garin29/Guitar-Amp-Sim/Audio processor V4 PCB Folder/3D View/Side View.PNG

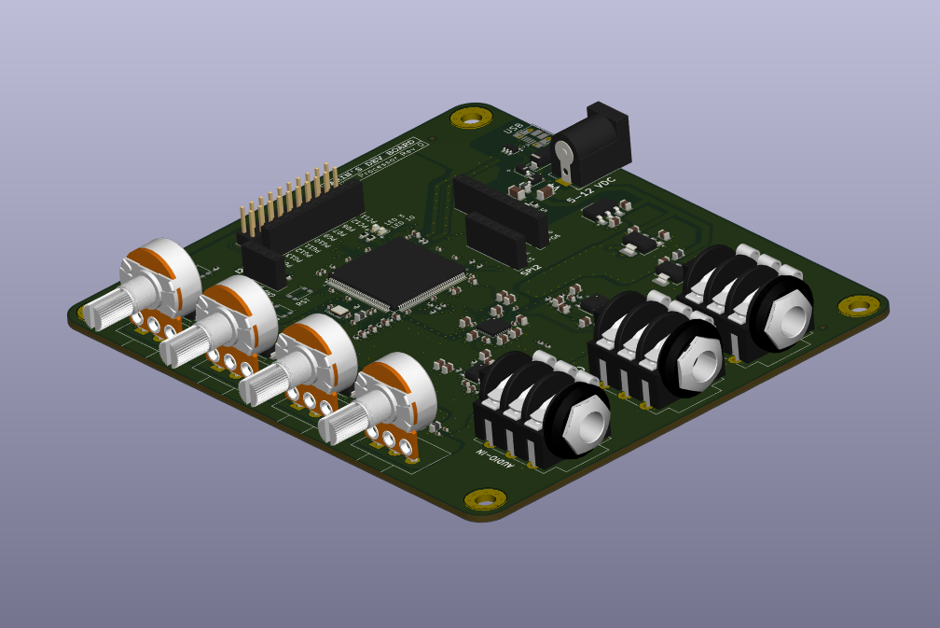
Audio processor V4 PCB Folder/3D View/Side View.PNG
