garin29/Guitar-Amp-Sim/Audio processor V4 PCB Folder/Schematic Audio Processor V.0.2.png

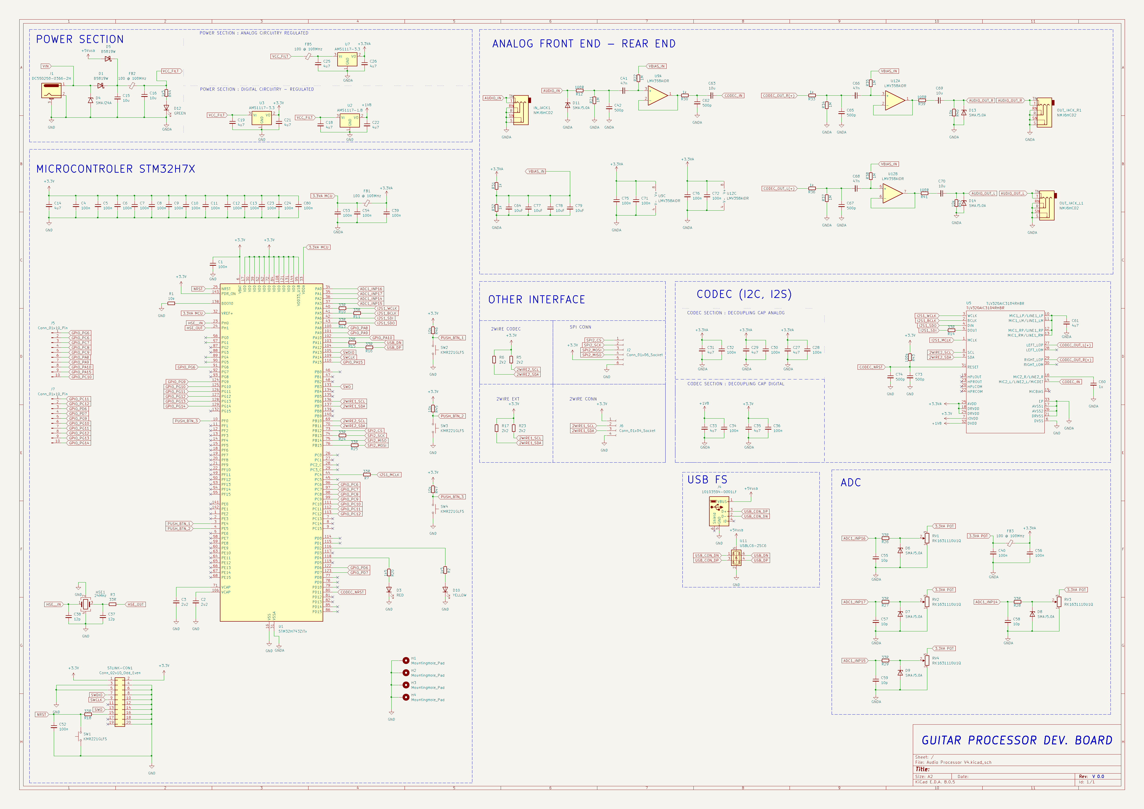
Audio processor V4 PCB Folder/Schematic Audio Processor V.0.2.png
