garin29/Guitar-Amp-Sim/Audio processor V4 PCB Folder/Assembly/Audio Processor V4 BOM - obs.csv

Comment | Designator | Footprint | LCSC
Conn_01x10_Pin | J7 | Connector_PinSocket_2.54mm:PinSocket_1x10_P2.54mm_Vertical | C22438160
Conn_01x10_Pin | J5 | Connector_PinSocket_2.54mm:PinSocket_1x10_P2.54mm_Vertical | C22438160
DC550250-0366-2H | J1 | Connector_BarrelJack:BarrelJack_Horizontal | C7428747
Conn_01x04_Socket | J6 | Connector_PinSocket_2.54mm:PinSocket_1x04_P2.54mm_Vertical | C2718488
USBLC6-2SC6 | U11 | Package_TO_SOT_SMD:TSOT-23-6 | C2687116
10103594-0001LF | J4 | Connector_USB:USB_Micro-B_Amphenol_10103594-0001LF_Horizontal | C428495
RK1631110U1Q | RV4 | Potentiometer_THT:Potentiometer_Alps_RK163_Single_Horizontal | C370978
RK1631110U1Q | RV3 | Potentiometer_THT:Potentiometer_Alps_RK163_Single_Horizontal | C370978
RK1631110U1Q | RV2 | Potentiometer_THT:Potentiometer_Alps_RK163_Single_Horizontal | C370978
RK1631110U1Q | RV1 | Potentiometer_THT:Potentiometer_Alps_RK163_Single_Horizontal | C370978
NMJ6HCD2 | OUT_JACK_R1 | Connector_Audio:Jack_6.35mm_Neutrik_NMJ6HCD2_Horizontal | C368502
NMJ6HCD2 | OUT_JACK_L1 | Connector_Audio:Jack_6.35mm_Neutrik_NMJ6HCD2_Horizontal | C368502
NMJ6HCD2 | IN_JACK1 | Connector_Audio:Jack_6.35mm_Neutrik_NMJ6HCD2_Horizontal | C368502
LMV358AIDR | U12 | Package_SO:PowerIntegrations_SO-8 | C182039
LMV358AIDR | U9 | Package_SO:PowerIntegrations_SO-8 | C182039
TLV320AIC3104RHBR | U5 | Package_DFN_QFN:VQFN-32-1EP_5x5mm_P0.5mm_EP3.5x3.5mm_ThermalVias | C181753
SMAJ24A | D4 | Diode_SMD:D_SMA | C148222
STM32H743ZITx | U1 | Package_QFP:LQFP-144_20x20mm_P0.5mm | C114408
SMAJ5.0A | D14 | Diode_SMD:D_SMA | C113952
SMAJ5.0A | D13 | Diode_SMD:D_SMA | C113952
SMAJ5.0A | D11 | Diode_SMD:D_SMA | C113952
SMAJ5.0A | D9 | Diode_SMD:D_SMA | C113952
SMAJ5.0A | D8 | Diode_SMD:D_SMA | C113952
SMAJ5.0A | D7 | Diode_SMD:D_SMA | C113952
SMAJ5.0A | D6 | Diode_SMD:D_SMA | C113952
KMR221GLFS | SW4 | Button_Switch_SMD:SW_Push_1P1T_NO_CK_KMR2 | C72443
KMR221GLFS | SW3 | Button_Switch_SMD:SW_Push_1P1T_NO_CK_KMR2 | C72443
KMR221GLFS | SW2 | Button_Switch_SMD:SW_Push_1P1T_NO_CK_KMR2 | C72443
KMR221GLFS | SW1 | Button_Switch_SMD:SW_Push_1P1T_NO_CK_KMR2 | C72443
B5819W | D5 | Diode_SMD:D_SOD-123 | C64885
B5819W | D1 | Diode_SMD:D_SOD-123 | C64885
Conn_01x06_Socket | J2 | Connector_PinSocket_2.54mm:PinSocket_1x06_P2.54mm_Vertical | C40877
1M | R38 | Resistor_SMD:R_0402_1005Metric | C26083
1M | R37 | Resistor_SMD:R_0402_1005Metric | C26083
1M | R35 | Resistor_SMD:R_0402_1005Metric | C26083
1M | R34 | Resistor_SMD:R_0402_1005Metric | C26083
1M | R22 | Resistor_SMD:R_0402_1005Metric | C26083
1M | R21 | Resistor_SMD:R_0402_1005Metric | C26083
10k | R47 | Resistor_SMD:R_0402_1005Metric | C25744
10k | R46 | Resistor_SMD:R_0402_1005Metric | C25744
10k | R45 | Resistor_SMD:R_0402_1005Metric | C25744
10k | R42 | Resistor_SMD:R_0402_1005Metric | C25744
10k | R40 | Resistor_SMD:R_0402_1005Metric | C25744
10k | R1 | Resistor_SMD:R_0402_1005Metric | C25744
100k | R43 | Capacitor_SMD:C_0402_1005Metric | C25530
33R | R29 | Resistor_SMD:R_0402_1005Metric | C25105
33R | R28 | Resistor_SMD:R_0402_1005Metric | C25105
33R | R27 | Resistor_SMD:R_0402_1005Metric | C25105
33R | R26 | Resistor_SMD:R_0402_1005Metric | C25105
33R | R25 | Resistor_SMD:R_0402_1005Metric | C25105
33R | R24 | Resistor_SMD:R_0402_1005Metric | C25105
33R | R18 | Resistor_SMD:R_0402_1005Metric | C25105
33R | R16 | Resistor_SMD:R_0402_1005Metric | C25105
33R | R15 | Resistor_SMD:R_0402_1005Metric | C25105
33R | R14 | Resistor_SMD:R_0402_1005Metric | C25105
33R | R13 | Resistor_SMD:R_0402_1005Metric | C25105
33R | R11 | Resistor_SMD:R_0402_1005Metric | C25105
33R | R10 | Resistor_SMD:R_0402_1005Metric | C25105
33R | R7 | Resistor_SMD:R_0402_1005Metric | C25105
33R | R3 | Resistor_SMD:R_0402_1005Metric | C25105
100R | R41 | Resistor_SMD:R_0402_1005Metric | C25076
100R | R39 | Resistor_SMD:R_0402_1005Metric | C25076
100R | R12 | Resistor_SMD:R_0402_1005Metric | C25076
1k5 | R44 | Resistor_SMD:R_0603_1608Metric | C22843
1k5 | R20 | Resistor_SMD:R_0603_1608Metric | C22843
1k5 | R2 | Resistor_SMD:R_0603_1608Metric | C22843
24MHz | HSE1 | Crystal:Crystal_SMD_3225-4Pin_3.2x2.5mm | C15643
1k | R36 | Resistor_SMD:R_0402_1005Metric | C11702
1k | R33 | Resistor_SMD:R_0402_1005Metric | C11702
1k | R32 | Resistor_SMD:R_0402_1005Metric | C11702
1k | R31 | Resistor_SMD:R_0402_1005Metric | C11702
1k | R30 | Resistor_SMD:R_0402_1005Metric | C11702
AMS1117-3.3 | U7 | Package_TO_SOT_SMD:SOT-223-3_TabPin2 | C6186
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
100n | C1 | Capacitor_SMD:C_0402_1005Metric | C1525
100 @ 100MHz | FB5 | Inductor_SMD:L_0805_2012Metric | C1015
100 @ 100MHz | FB3 | Inductor_SMD:L_0805_2012Metric | C1015
100 @ 100MHz | FB2 | Inductor_SMD:L_0805_2012Metric | C1015
100 @ 100MHz | FB1 | Inductor_SMD:L_0805_2012Metric | C1015
