garin29/Guitar-Amp-Sim/Audio processor V4 PCB Folder/Audio Processor V4.kicad_pcb

## KiCad design Audio processor V4 PCB Folder/Audio Processor V4.kicad_pcb (2025-03-13)

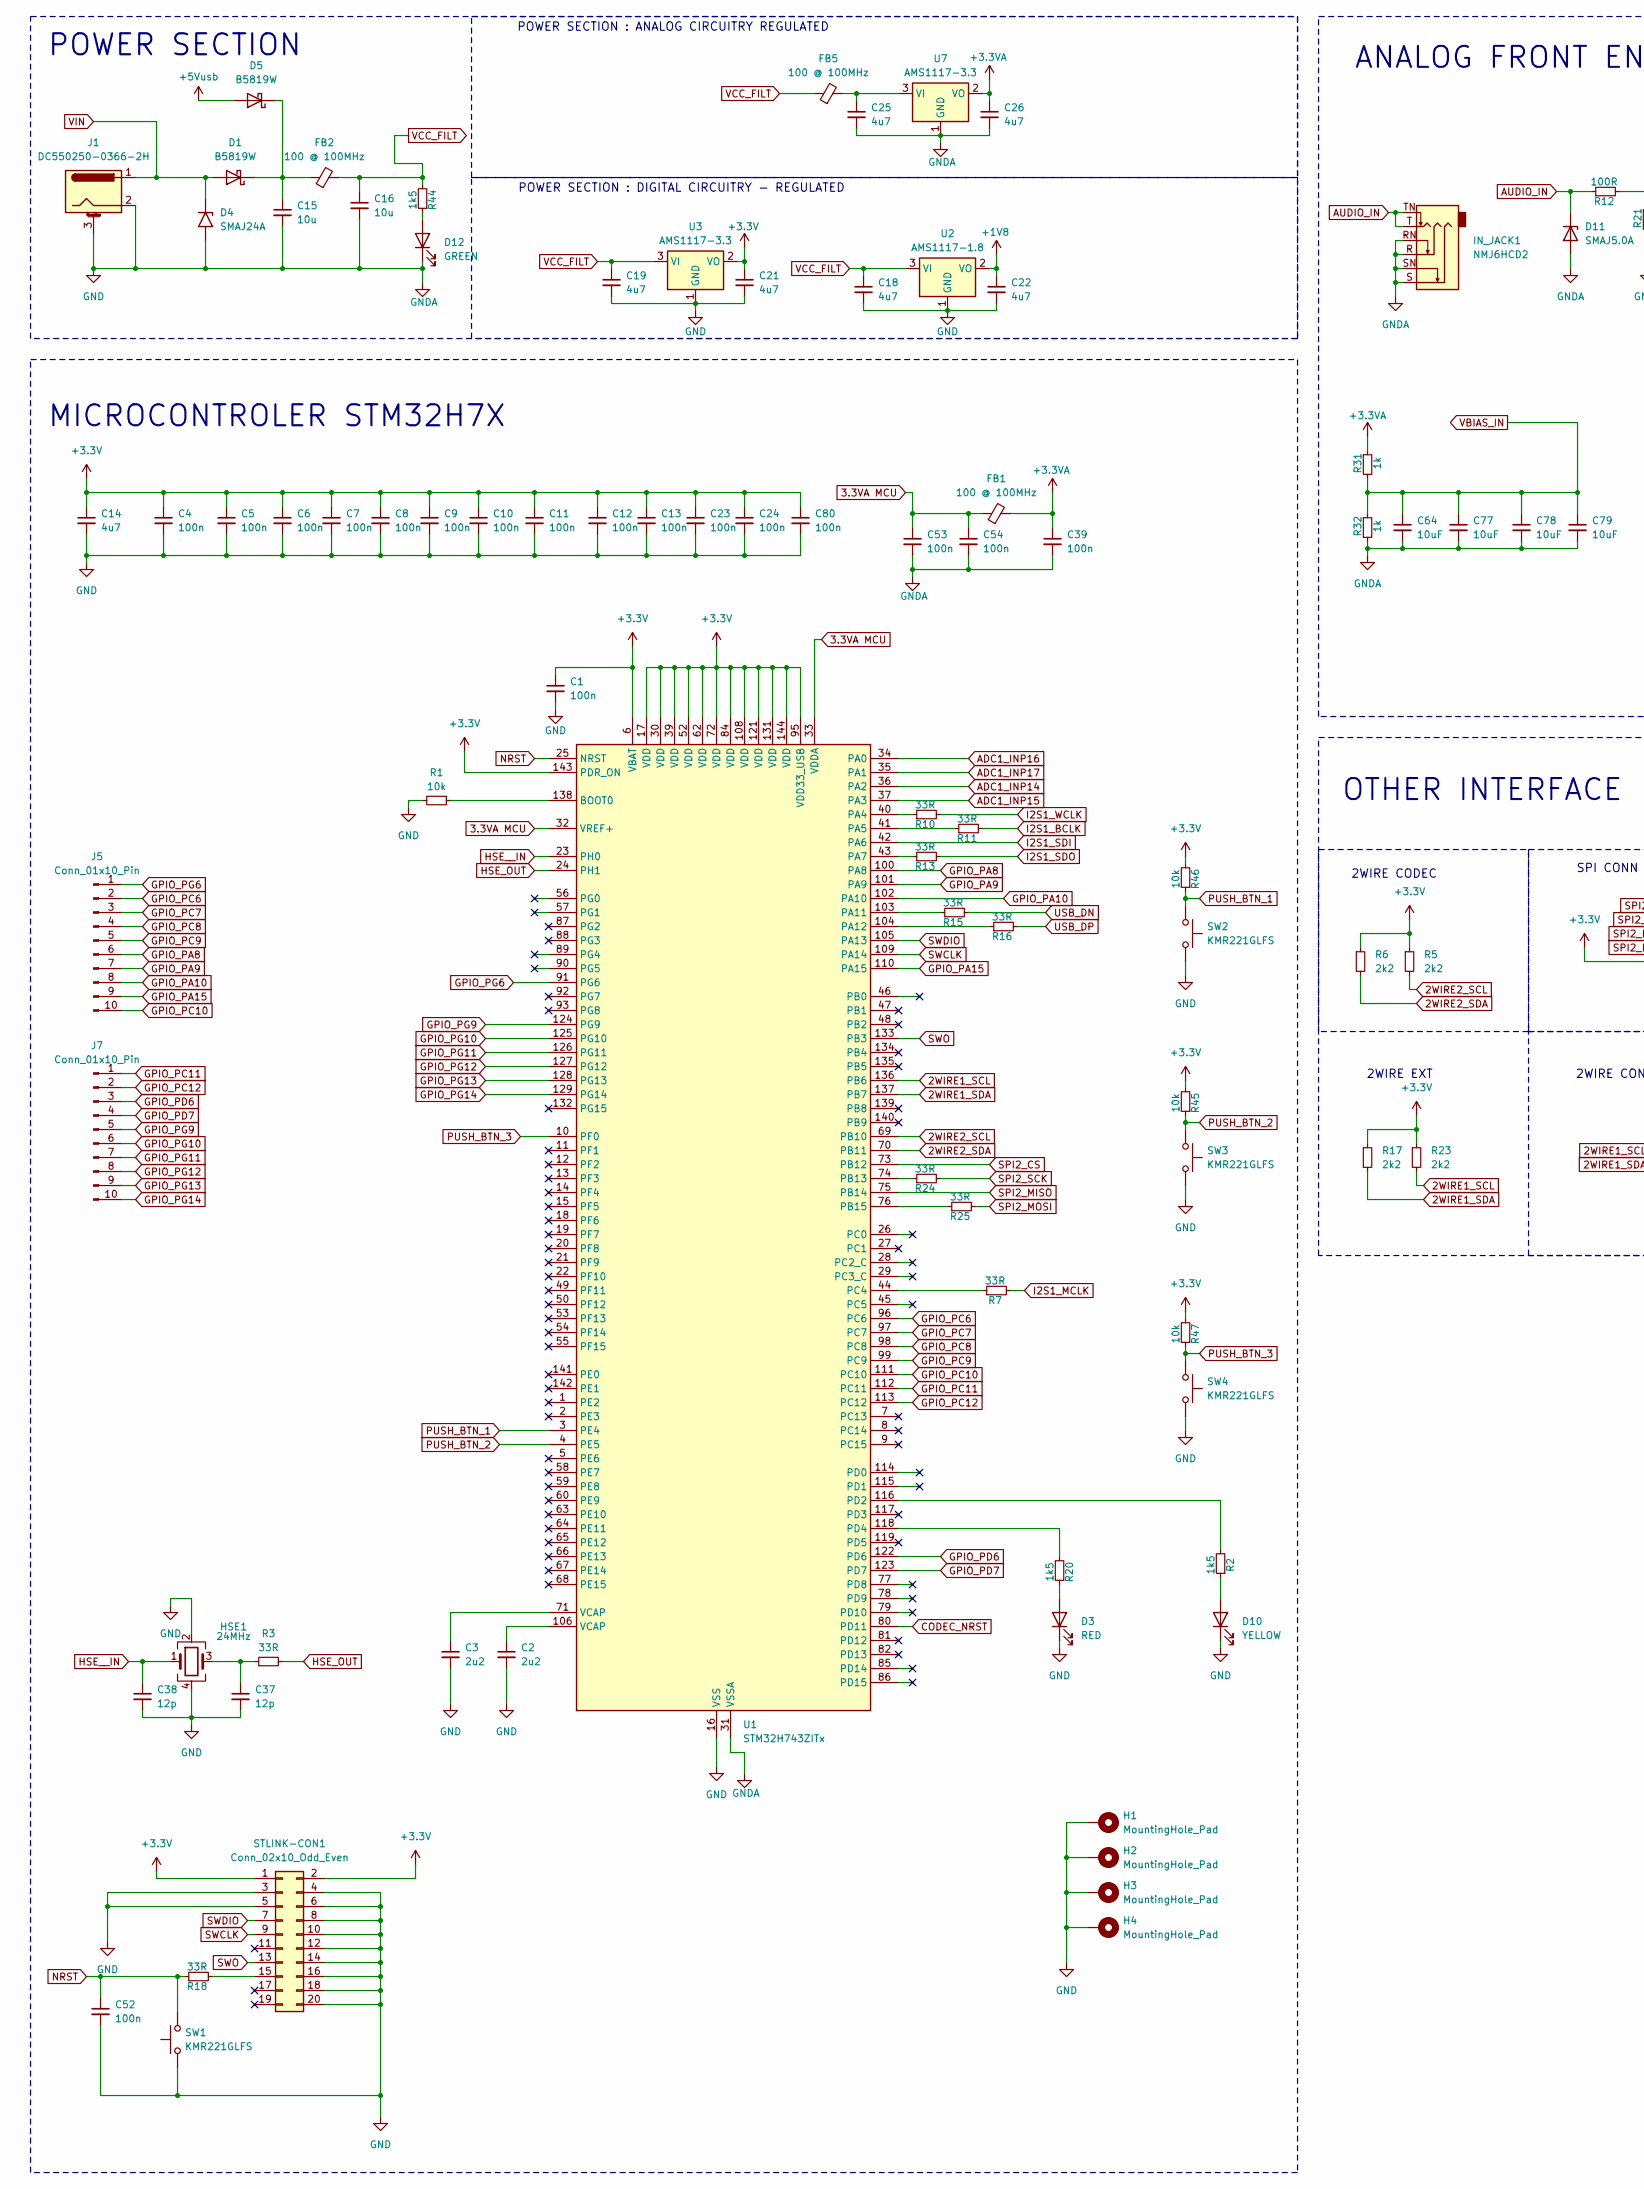
[picture p21: schematic Audio Processor V4.kicad_sch, part in row 1, column 1]

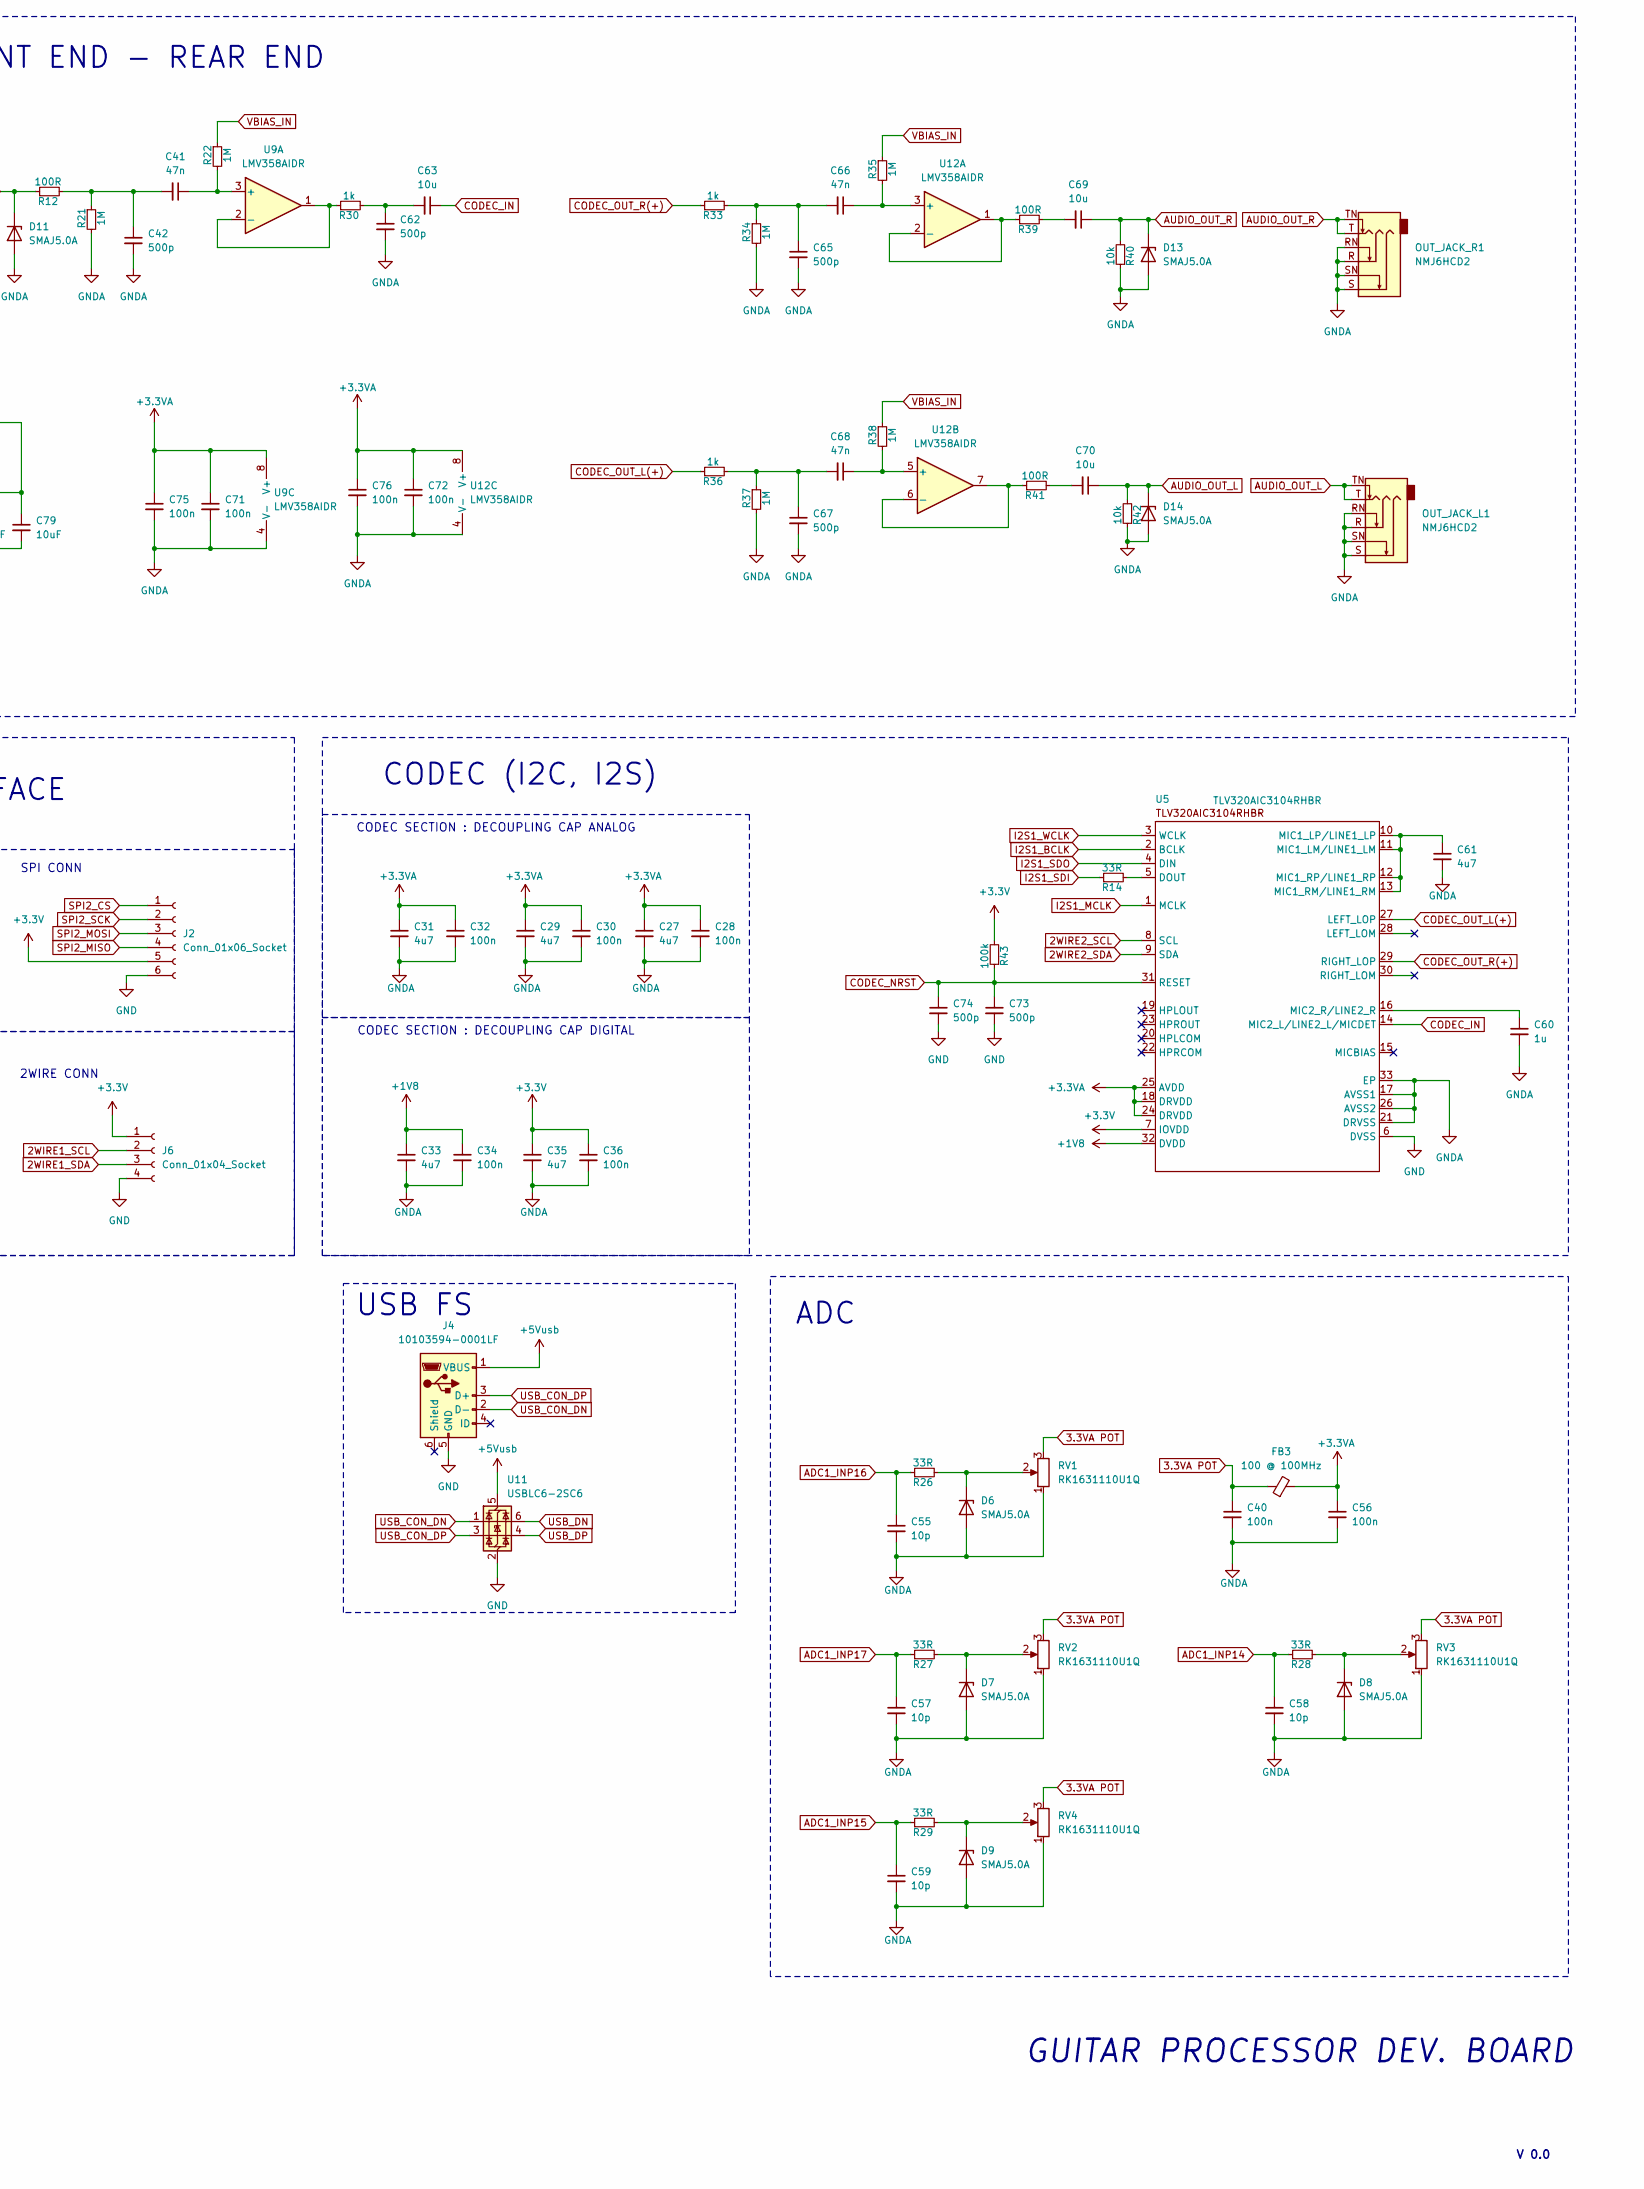
[picture p22: schematic Audio Processor V4.kicad_sch, part in row 1, column 2]

Parts:
C1, C4, C5, C6, C7, C8, C9, C10, C11, C12, C13, C23, C24, C28, C30, C32, C34, C36, C39, C40, C52, C53, C54, C56, C71, C72, C75, C76, C80: 100n; C_0402_1005Metric; LCSC C1525
C2, C3: 2u2; C_0603_1608Metric; LCSC C1607
C14: 4u7; C_0603_1608Metric; LCSC C1705
C15, C16: 10u; C_1206_3216Metric; LCSC C1849
C18, C19, C21, C22, C25, C26, C27, C29, C31, C33, C35, C61: 4u7; C_0805_2012Metric; LCSC C1746
C37, C38: 12p; C_0402_1005Metric; LCSC C1547
C41, C66, C68: 47n; C_0603_1608Metric; LCSC C1622
C42: 500p; C_0603_1608Metric; LCSC C1747
C55, C57, C58, C59: 10p; C_0603_1608Metric; LCSC C1634
C60: 1u; C_0603_1608Metric; LCSC C1592
C62, C65, C67, C73, C74: 500p; C_0805_2012Metric; LCSC C1747
C63, C69, C70: 10u; C_0805_2012Metric; LCSC C1713
C64, C77, C78, C79: 10uF; C_0805_2012Metric; LCSC C1713
D1, D5: B5819W; D_SOD-123; LCSC C64885
D3: RED; LED_0603_1608Metric; LCSC C2286
D4: SMAJ24A; D_SMA; LCSC C148222
D6, D7, D8, D9, D11, D13, D14: SMAJ5.0A; D_SMA; LCSC C113952
D10: YELLOW; LED_0603_1608Metric; LCSC C2287
D12: GREEN; LED_0805_2012Metric; LCSC C2297
FB1, FB2, FB3, FB5: 100 @ 100MHz; L_0805_2012Metric; LCSC C1015
H1, H2, H3, H4: MountingHole_Pad; MountingHole_4.3mm_M4_Pad_Via
HSE1: 24MHz; Crystal_SMD_3225-4Pin_3.2x2.5mm; LCSC C15643
IN_JACK1: NMJ6HCD2; Jack_6.35mm_Neutrik_NMJ6HCD2_Horizontal; LCSC C368502
J1: DC550250-0366-2H; BarrelJack_Horizontal; LCSC C7428747
J2: Conn_01x06_Socket; PinSocket_1x06_P2.54mm_Vertical; LCSC C40877
J4: 10103594-0001LF; USB_Micro-B_Amphenol_10103594-0001LF_Horizontal; LCSC C428495
J5, J7: Conn_01x10_Pin; PinSocket_1x10_P2.54mm_Vertical; LCSC C22438160
J6: Conn_01x04_Socket; PinSocket_1x04_P2.54mm_Vertical; LCSC C2718488
OUT_JACK_L1: NMJ6HCD2; Jack_6.35mm_Neutrik_NMJ6HCD2_Horizontal; LCSC C368502
OUT_JACK_R1: NMJ6HCD2; Jack_6.35mm_Neutrik_NMJ6HCD2_Horizontal; LCSC C368502
R1, R40, R42, R45, R46, R47: 10k; R_0402_1005Metric; LCSC C25744
R2, R20, R44: 1k5; R_0603_1608Metric; LCSC C22843
R3, R7, R10, R11, R13, R14, R15, R16, R18, R24, R25, R26, R27, R28, R29: 33R; R_0402_1005Metric; LCSC C25105
R5, R6, R17, R23: 2k2; R_0603_1608Metric; LCSC C4190
R12, R39, R41: 100R; R_0402_1005Metric; LCSC C25076
R21, R22, R34, R35, R37, R38: 1M; R_0402_1005Metric; LCSC C26083
R30, R31, R32, R33, R36: 1k; R_0402_1005Metric; LCSC C11702
R43: 100k; C_0402_1005Metric; LCSC C25530
RV1, RV2, RV3, RV4: RK1631110U1Q; Potentiometer_Alps_RK163_Single_Horizontal; LCSC C370978
STLINK-CON1: Conn_02x10_Odd_Even; PinHeader_2x10_P2.54mm_Vertical; LCSC C3405
SW1, SW2, SW3, SW4: KMR221GLFS; SW_Push_1P1T_NO_CK_KMR2; LCSC C72443
U1: STM32H743ZITx; LQFP-144_20x20mm_P0.5mm; LCSC C114408
U2: AMS1117-1.8; SOT-223-3_TabPin2; LCSC C6185
U3, U7: AMS1117-3.3; SOT-223-3_TabPin2; LCSC C6186
U5: TLV320AIC3104RHBR; VQFN-32-1EP_5x5mm_P0.5mm_EP3.5x3.5mm_ThermalVias; LCSC C181753
U9, U12: LMV358AIDR; PowerIntegrations_SO-8; LCSC C182039
U11: USBLC6-2SC6; TSOT-23-6; LCSC C2687116

Connections:
2WIRE1_SCL: J6.2, R23.2, U1.136 (PB6)
2WIRE1_SDA: J6.3, R17.2, U1.137 (PB7)
2WIRE2_SCL: R5.2, U1.69 (PB10), U5.8 (SCL)
2WIRE2_SDA: R6.2, U1.70 (PB11), U5.9 (SDA)
3.3VA MCU: C53.1, C54.1, FB1.1, U1.32 (VREF+), U1.33 (VDDA)
3.3VA POT: C40.1, FB3.1, RV1.3, RV2.3, RV3.3, RV4.3
+1V8: C22.1, C33.1, C34.1, U2.2 (VO), U5.32 (DVDD)
+3.3V: C1.1, C4.1, C5.1, C6.1, C7.1, C8.1, C9.1, C10.1, C11.1, C12.1, C13.1, C14.1, C21.1, C23.1, C24.1, C35.1, C36.1, C80.1, J2.5, J6.1, R5.1, R6.1, R17.1, R23.1, R43.2, R45.2, R46.2, R47.2, STLINK-CON1.1, STLINK-CON1.2, U1.6 (VBAT), U1.17 (VDD), U1.30 (VDD), U1.39 (VDD), U1.52 (VDD), U1.62 (VDD), U1.72 (VDD), U1.84 (VDD), U1.95 (VDD33_USB), U1.108 (VDD), U1.121 (VDD), U1.131 (VDD), U1.143 (PDR_ON), U1.144 (VDD), U3.2 (VO), U5.7 (IOVDD)
+3.3VA: C26.1, C27.1, C28.1, C29.1, C30.1, C31.1, C32.1, C39.1, C56.1, C71.1, C72.1, C75.1, C76.1, FB1.2, FB3.2, R31.1, U5.18 (DRVDD), U5.24 (DRVDD), U5.25 (AVDD), U7.2 (VO), U9.8 (V+), U12.8 (V+)
+5Vusb: D5.2 (A), J4.1 (VBUS), U11.5 (VBUS)
ADC1_INP14: C58.1, R28.1, U1.36 (PA2)
ADC1_INP15: C59.1, R29.1, U1.37 (PA3)
ADC1_INP16: C55.1, R26.1, U1.34 (PA0)
ADC1_INP17: C57.1, R27.1, U1.35 (PA1)
AUDIO_IN: D11.1 (K), IN_JACK1.T, IN_JACK1.TN, R12.1
AUDIO_OUT_L: C70.1, D14.1 (K), OUT_JACK_L1.T, OUT_JACK_L1.TN, R42.2
AUDIO_OUT_R: C69.1, D13.1 (K), OUT_JACK_R1.T, OUT_JACK_R1.TN, R40.2
CODEC_IN: C63.1, U5.14 (MIC2_L/LINE2_L/MICDET)
CODEC_NRST: C73.1, C74.1, R43.1, U1.80 (PD11), U5.31 (RESET)
CODEC_OUT_L(+): R36.1, U5.27 (LEFT_LOP)
CODEC_OUT_R(+): R33.1, U5.29 (RIGHT_LOP)
GND: C1.2, C2.2, C3.2, C4.2, C5.2, C6.2, C7.2, C8.2, C9.2, C10.2, C11.2, C12.2, C13.2, C14.2, C15.2, C16.2, C18.2, C19.2, C21.2, C22.2, C23.2, C24.2, C25.2, C26.2, C27.2, C28.2, C29.2, C30.2, C31.2, C32.2, C33.2, C34.2, C35.2, C36.2, C37.2, C38.2, C39.2, C40.2, C42.2, C52.2, C53.2, C54.2, C55.2, C56.2, C57.2, C58.2, C59.2, C60.2, C61.2, C62.2, C64.2, C65.2, C67.2, C71.2, C72.2, C73.2, C74.2, C75.2, C76.2, C77.2, C78.2, C79.2, C80.2, D3.1 (K), D4.2 (A2), D6.2 (A), D7.2 (A), D8.2 (A), D9.2 (A), D10.1 (K), D11.2 (A), D12.1 (K), D13.2 (A), D14.2 (A), H1.1, H2.1, H3.1, H4.1, HSE1.2, HSE1.4, IN_JACK1.R, IN_JACK1.RN, IN_JACK1.S, IN_JACK1.SN, J1.2, J1.3 (MountPin), J2.6, J4.5 (GND), J6.4, OUT_JACK_L1.R, OUT_JACK_L1.RN, OUT_JACK_L1.S, OUT_JACK_L1.SN, OUT_JACK_R1.R, OUT_JACK_R1.RN, OUT_JACK_R1.S, OUT_JACK_R1.SN, R1.2, R21.2, R32.2, R34.2, R37.2, R40.1, R42.1, RV1.1, RV2.1, RV3.1, RV4.1, STLINK-CON1.3, STLINK-CON1.4, STLINK-CON1.5, STLINK-CON1.6, STLINK-CON1.8, STLINK-CON1.10, STLINK-CON1.12, STLINK-CON1.14, STLINK-CON1.16, STLINK-CON1.18, STLINK-CON1.20, SW1.1, SW2.2, SW3.2, SW4.2, U1.16 (VSS), U1.31 (VSSA), U1.38 (VSS), U1.51 (VSS), U1.61 (VSS), U1.83 (VSS), U1.94 (VSS), U1.107 (VSS), U1.120 (VSS), U1.130 (VSS), U2.1 (GND), U3.1 (GND), U5.6 (DVSS), U5.17 (AVSS1), U5.21 (DRVSS), U5.26 (AVSS2), U5.33 (EP), U7.1 (GND), U9.4 (V-), U11.2 (GND), U12.4 (V-)
GPIO_PA8: J5.6, U1.100 (PA8)
GPIO_PA9: J5.7, U1.101 (PA9)
GPIO_PA10: J5.8, U1.102 (PA10)
GPIO_PA15: J5.9, U1.110 (PA15)
GPIO_PC6: J5.2, U1.96 (PC6)
GPIO_PC7: J5.3, U1.97 (PC7)
GPIO_PC8: J5.4, U1.98 (PC8)
GPIO_PC9: J5.5, U1.99 (PC9)
GPIO_PC10: J5.10, U1.111 (PC10)
GPIO_PC11: J7.1, U1.112 (PC11)
GPIO_PC12: J7.2, U1.113 (PC12)
GPIO_PD6: J7.3, U1.122 (PD6)
GPIO_PD7: J7.4, U1.123 (PD7)
GPIO_PG6: J5.1, U1.91 (PG6)
GPIO_PG9: J7.5, U1.124 (PG9)
GPIO_PG10: J7.6, U1.125 (PG10)
GPIO_PG11: J7.7, U1.126 (PG11)
GPIO_PG12: J7.8, U1.127 (PG12)
GPIO_PG13: J7.9, U1.128 (PG13)
GPIO_PG14: J7.10, U1.129 (PG14)
HSE_OUT: R3.2, U1.24 (PH1)
HSE__IN: C38.1, HSE1.1, U1.23 (PH0)
I2S1_BCLK: R11.2, U5.2 (BCLK)
I2S1_MCLK: R7.2, U5.1 (MCLK)
I2S1_SDI: R14.1, U1.42 (PA6)
I2S1_SDO: R13.2, U5.4 (DIN)
I2S1_WCLK: R10.2, U5.3 (WCLK)
NRST: C52.1, R18.1, SW1.2, U1.25 (NRST)
unnamed: C2.1, U1.106 (VCAP)
unnamed: C3.1, U1.71 (VCAP)
unnamed: C37.1, HSE1.3, R3.1
unnamed: C41.2, C42.1, R12.2, R21.1
unnamed: C62.1, C63.2, R30.2
unnamed: C65.1, C66.2, R33.2, R34.1
unnamed: C67.1, C68.2, R36.2, R37.1
unnamed: C69.2, R39.2
unnamed: C70.2, R41.2
unnamed: C15.1, D1.1 (K), D5.1 (K), FB2.1
unnamed: D3.2 (A), R20.1
unnamed: D6.1 (K), R26.2, RV1.2
unnamed: D7.1 (K), R27.2, RV2.2
unnamed: D8.1 (K), R28.2, RV3.2
unnamed: D9.1 (K), R29.2, RV4.2
unnamed: D10.2 (A), R2.1
unnamed: D12.2 (A), R44.1
unnamed: R18.2, STLINK-CON1.15
unnamed: R1.1, U1.138 (BOOT0)
unnamed: R10.1, U1.40 (PA4)
unnamed: R11.1, U1.41 (PA5)
unnamed: R13.1, U1.43 (PA7)
unnamed: R15.1, U1.103 (PA11)
unnamed: R16.1, U1.104 (PA12)
unnamed: R24.1, U1.74 (PB13)
unnamed: R25.1, U1.76 (PB15)
unnamed: R7.1, U1.44 (PC4)
unnamed: R2.2, U1.116 (PD2)
unnamed: R20.2, U1.118 (PD4)
unnamed: R14.2, U5.5 (DOUT)
unnamed: C61.1, U5.10 (MIC1_LP/LINE1_LP), U5.11 (MIC1_LM/LINE1_LM), U5.12 (MIC1_RP/LINE1_RP), U5.13 (MIC1_RM/LINE1_RM)
unnamed: C60.1, U5.16 (MIC2_R/LINE2_R)
unnamed: C25.1, FB5.2, U7.3 (VI)
unnamed: C41.1, R22.2, U9.3 (+)
unnamed: R30.1, U9.1, U9.2 (-)
unnamed: C66.1, R35.2, U12.3 (+)
unnamed: R39.1, U12.1, U12.2 (-)
unnamed: C68.1, R38.2, U12.5 (+)
unnamed: R41.1, U12.6 (-), U12.7
PUSH_BTN_1: R46.1, SW2.1, U1.3 (PE4)
PUSH_BTN_2: R45.1, SW3.1, U1.4 (PE5)
PUSH_BTN_3: R47.1, SW4.1, U1.10 (PF0)
SPI2_CS: J2.1, U1.73 (PB12)
SPI2_MISO: J2.4, U1.75 (PB14)
SPI2_MOSI: J2.3, R25.2
SPI2_SCK: J2.2, R24.2
SWCLK: STLINK-CON1.9, U1.109 (PA14)
SWDIO: STLINK-CON1.7, U1.105 (PA13)
SWO: STLINK-CON1.13, U1.133 (PB3)
USB_CON_DN: J4.2 (D-), U11.1 (I/O1)
USB_CON_DP: J4.3 (D+), U11.3 (I/O2)
USB_DN: R15.2, U11.6 (I/O1)
USB_DP: R16.2, U11.4 (I/O2)
VBIAS_IN: C64.1, C77.1, C78.1, C79.1, R22.1, R31.2, R32.1, R35.1, R38.1
VCC_FILT: C16.1, C18.1, C19.1, FB2.2, FB5.1, R44.2, U2.3 (VI), U3.3 (VI)
VIN: D1.2 (A), D4.1 (A1), J1.1

Notes on the sheet:
MICROCONTROLER STM32H7X
OTHER INTERFACE
POWER SECTION : DIGITAL CIRCUITRY - REGULATED
CODEC SECTION : DECOUPLING CAP DIGITAL
POWER SECTION : ANALOG CIRCUITRY REGULATED
GUITAR PROCESSOR DEV. BOARD
2WIRE CODEC
USB FS
POWER SECTION
SPI CONN
CODEC SECTION : DECOUPLING CAP ANALOG
ANALOG FRONT END - REAR END
CODEC (I2C, I2S)
V 0.0
2WIRE EXT
ADC
2WIRE CONN

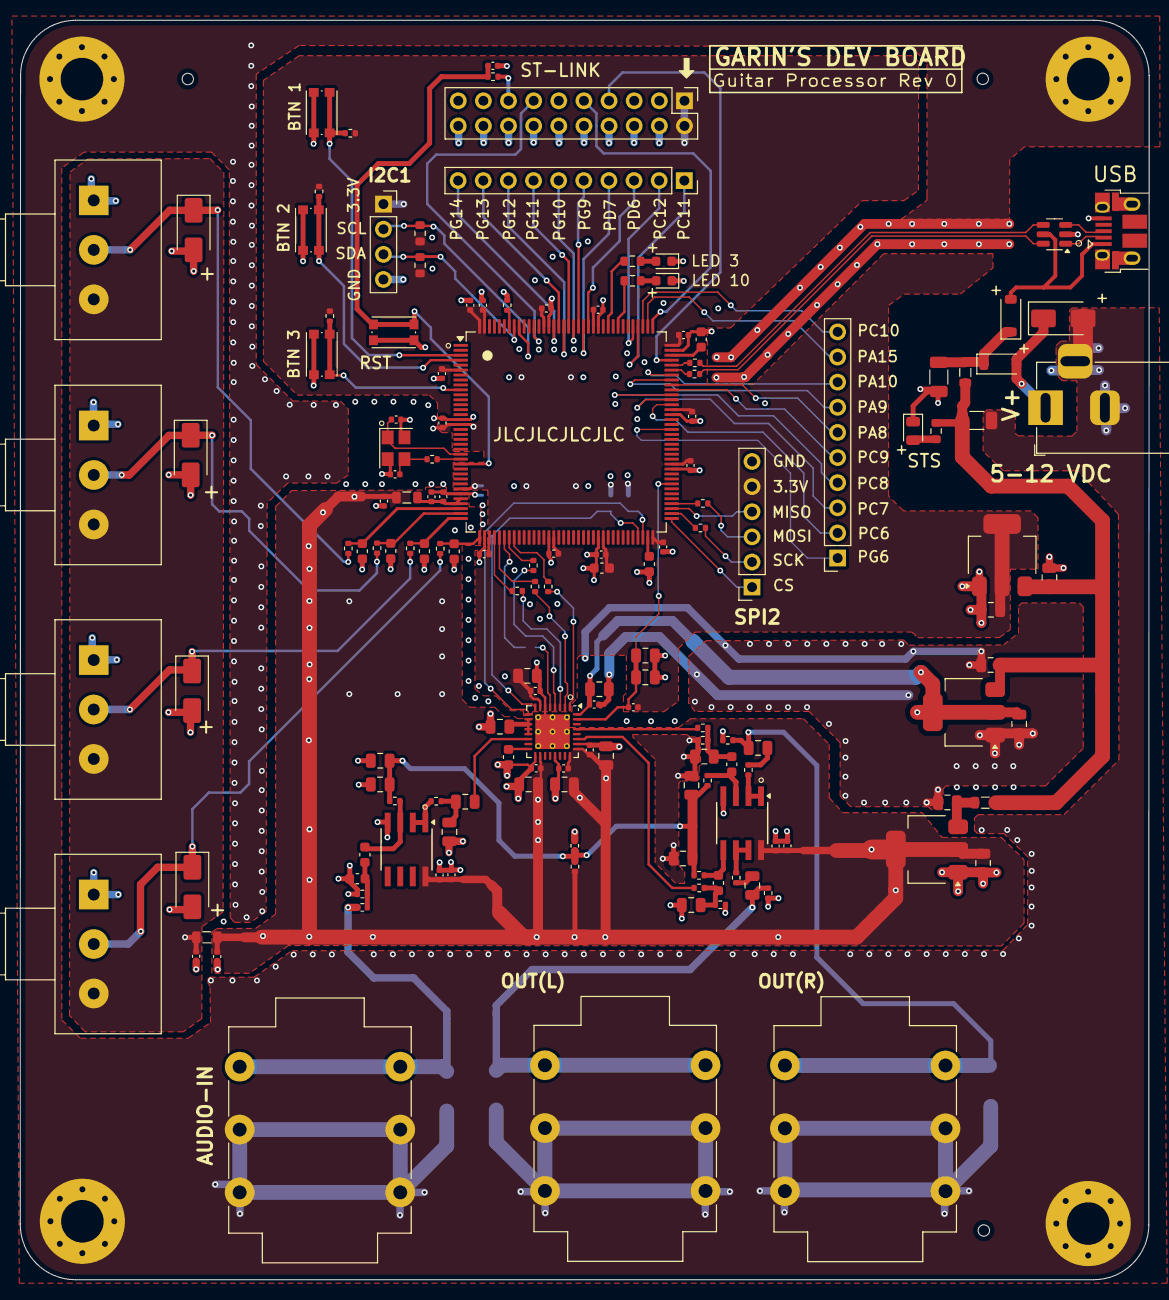
[picture p23: board Audio Processor V4.kicad_pcb from above]

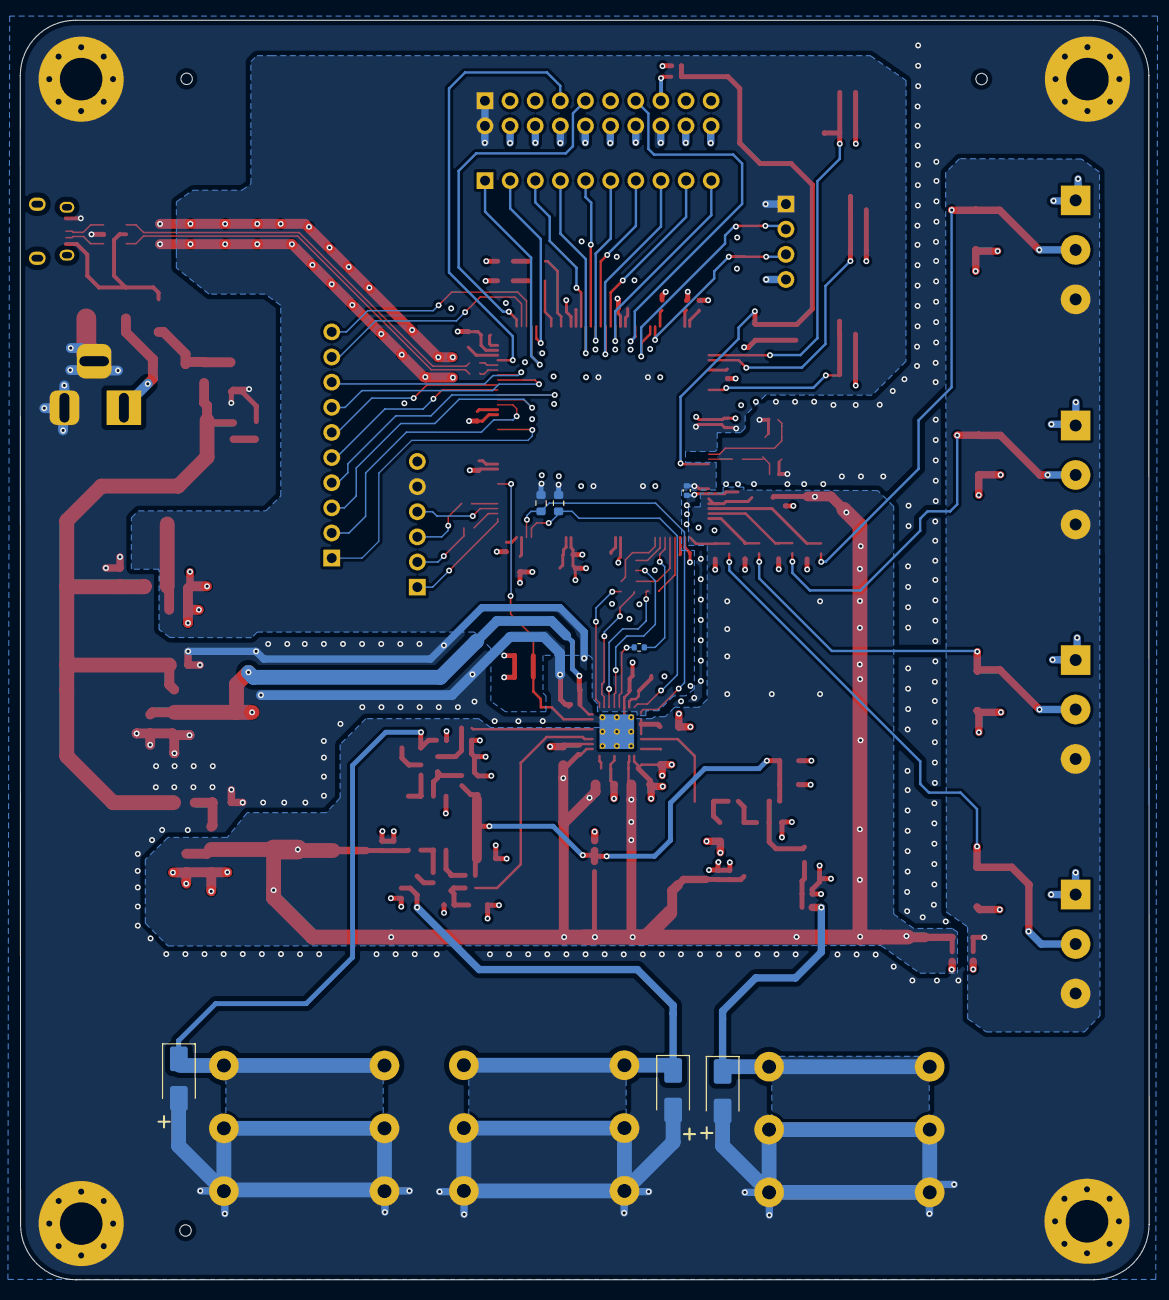
[picture p24: board Audio Processor V4.kicad_pcb from below]

Board: 4 copper layers, 114.1 x 127.3 mm, 160 parts (7 on the bottom side), 106 nets.
