garin29/Guitar-Amp-Sim/Core/Src/main.c

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
/* Includes ------------------------------------------------------------------*/
#include "main.h"

/* USER CODE BEGIN Includes */
#include "TLV320AIC3104.h"
#include "Audio_IO.h"
#include "Audio_FIR.h"
#include "Audio_QIIR.h"
#include "Audio_Nonlinearity.h"
#include "AntiAlias10k.h"
#include "MesaBoogie_Tight1_SM57.h"

/* USER CODE END Includes */

/* USER CODE BEGIN PD */
#define NUM_OF_POT 4
#define ADC16_RANGE 65535.0f
#define ADC12_RANGE 4095.0f
#define ADC16_TO_1BASE 0.000015259f
#define ADC16_TO_5BASE 0.000076295f
#define ADC16_TO_30BASE 0.0004577706f
#define AUDIO_BUFF_SIZE16 256

#define INT16_TO_FLOAT (1.0f/32767.0f)
#define INT24_TO_FLOAT (1.0f/8388607.0f)
#define UINT32_TO_FLOAT (1.0f/4294967295.0f)
#define UINT16_TO_FLOAT (1.0f/65535.0f)
#define INT32_TO_FLOAT (1.0f/2147483647.0f)
#define UINT24_TO_FLOAT (1.0f/16777215.0f)
#define FLOAT_TO_INT16 32767
#define FLOAT_TO_INT24 8388607
#define FLOAT_TO_UINT32 4294967295.0f
#define FLOAT_TO_INT32 2147483647.0f
#define FLOAT_TO_UINT24 16777215.0f
#define FLOAT_TO_UINT16 65535.0f
#define CAN_PROCEED_STREAM 1U
#define DONT_PROCEED_STREAM 0U
#define ACTUAL_FS 47753.0f
#define ACTUAL_TS 1/ACTUAL_FS
#define IR_LEN 		1024
#define FX_ACTIVE	1
#define FX_BYPASS	0
#define CRUNCH_MODE 1
#define LEAD_MODE 0

/* USER CODE END PD */

ADC_HandleTypeDef hadc1;
DMA_HandleTypeDef hdma_adc1;

I2C_HandleTypeDef hi2c1;
I2C_HandleTypeDef hi2c2;

I2S_HandleTypeDef hi2s1;
DMA_HandleTypeDef hdma_spi1_rx;
DMA_HandleTypeDef hdma_spi1_tx;

TIM_HandleTypeDef htim8;

/* USER CODE BEGIN PV */

float Global_Lvl_Inp = 0.8f;
float Global_Lvl_Out = 0.6f;
AIC320_CTL_OBJ AIC320_codec;
FIR_Struct AntiAliasing_LowPass;
QIIR_Struct Pregain_IIR0;
QIIR_Struct Pregain_IIR1;
QIIR_Struct Pregain_IIR2;
QIIR_Struct Pregain_IIR3;
QIIR_Struct Pregain_IIR4;
QIIR_Struct Pregain_IIR5;
QIIR_Struct Pregain_IIR6;
Drive_Struct GainStage1;
QIIR_Struct MidGain_IIR0;
QIIR_Struct MidGain_IIR1;
QIIR_Struct MidGain_IIR2;
QIIR_Struct MidGain_IIR3;
Drive_Struct GainStage2;
QIIR_Struct PostGain_IIR0;
QIIR_Struct PostGain_IIR1;
QIIR_Struct PostGain_IIR2;
QIIR_Struct PostGain_IIR3;
QIIR_Struct PostGain_IIR4;
QIIR_Struct PostGain_HP;
FIR_Struct Cabinet_IR;


float AntiAlias_LowPass_Buff[ANTI_ALIAS10_SIZE] = {0};
float Cabinet_IR_Buff[IR_LEN] = {0};

typedef enum knob_type{KNOB_OFF, KNOB_GAIN, KNOB_Q, KNOB_FREQ, KNOB_FREQ_GAIN, KNOB_VOL_OUT} Knob_Type;
Knob_Type Current_Knob_Type = KNOB_OFF;

volatile uint16_t POT_DATA[NUM_OF_POT] __attribute__((section(".nocache")));;
float POT_1BASE[NUM_OF_POT] = {0.0f, 0.0f, 0.0f, 0.0f};
volatile float POT_5BASE[NUM_OF_POT] = {0, 0, 0, 0};
volatile float POT_30BASE[NUM_OF_POT] = {0, 0, 0, 0};
float Control_Knob_Val[NUM_OF_POT] = {0, 0, 0, 0};

uint8_t  fx_switch = FX_BYPASS;
uint8_t  Gain_Mode = LEAD_MODE;
uint8_t Button_Assign_To_Process_ID = 0;
const uint8_t Max_Btn_Assignment = 14;
Run_Status Current_Run_State = ON_RUN;
Run_Status Change_Request_Status = ON_RUN;

volatile uint8_t Stream_Status = 0;
uint8_t I2S_Startup_Sts = 0;

volatile int16_t Audio_ADC_Buff[AUDIO_BUFF_SIZE16]  __attribute__((section(".nocache")));;;
volatile int16_t Audio_DAC_Buff[AUDIO_BUFF_SIZE16]  __attribute__((section(".nocache")));;;
static volatile int16_t *Audio_Inp_Ptr;
static volatile int16_t *Audio_Out_Ptr = &Audio_DAC_Buff[0];

//*************ON THE GO ADJUSTABLE PARM***********************//
float 			Run_Gain_Max = 100.0f;
float 			Run_Gain_Min = 10.0f;
volatile float 	Run_Gain = 0.0f;
float			Run_Gain_Scale = 0.0f;
float			Run_Gain_Conv_Factor = 0.0f;

float  			Run_Vol_Max = 0.9f;
float  			Run_Vol_Min = 0.0f;
volatile float	Run_Vol = 0.0f;
float 			Run_Vol_Scale = 0.0f;
float 			Run_Vol_Conv_Factor = 0.0f;

float			Run_High_Max = 16000.0f;
float			Run_High_Min = 4000.0f;
volatile float 	Run_High = 0.0f;
float			Run_High_Scale = 0.0f;
float			Run_High_Conv_Factor = 0.0f;

float			Run_LowCut_Scale = 270.0f;
float			Run_LowCut_Min = 30.0f;
volatile float	Run_Low = 0.0f;
float			Run_LowCut_Max = 0.0f;
float			Run_LowCut_Conv_Factor = 0.0f;

//***********WATCH, TEST, AND DEBUG HERE!******************//
float wGain = 0;
float wQ = 0;
float wF0 = 0;
float wVolout = 0;
float wGainB = 0;
float wQB = 0;
float wF0B = 0;
float wVoloutB = 0;
float in_floated = 0.0f;
float out_floated = 0.0f;
float tinx = 0;
float tox = 0;
int16_t i1 = 0;
int16_t i2 = 0;
int16_t i2_neg = 0;
int16_t o1 = 0;
int16_t o2 = 0;


int32_t inp_i16_0 = 0;
int32_t inp_i16_1 = 0;
int32_t inp_i16_2 = 0;
int32_t inp_i16_3 = 0;
int32_t inp_i16_s = 0;

int32_t out_i16_0 = 0;
int32_t out_i16_1 = 0;
int32_t out_i16_2 = 0;
int32_t out_i16_3 = 0;
int32_t out_i16_s = 0;


int8_t i2_tmp_int = 0;
int8_t o2_tmp_int = 0;
int8_t i2_tmps_int = 0;
int8_t o2_tmps_int = 0;

float dsp1 = 0.0f;
float dsp2 = 0.0f;
float dsp3 = 0.0f;

int32_t i1_int_combined = 0;
uint32_t i1_uint_combined = 0;
uint32_t i2s = 0;
int32_t o1_int_combined = 0;
uint32_t o_uint_combined = 0;
uint32_t o2s = 0;


/* USER CODE END PV */

void SystemClock_Config(void);
void PeriphCommonClock_Config(void);
static void MPU_Config(void);
static void MX_GPIO_Init(void);
static void MX_DMA_Init(void);
static void MX_I2C1_Init(void);
static void MX_I2S1_Init(void);
static void MX_ADC1_Init(void);
static void MX_I2C2_Init(void);
static void MX_TIM8_Init(void);
/* USER CODE BEGIN PFP */

void Process_Audio();
void Check_Current_Knob_Assignment();
void Check_State_Change_Request();
void Init_AntiAlias10_Filter();
void Init_Cabinet_IR();
void ProcessAll_PreGain1();
void ProcessAll_PostGain1();
void ProcessAll_PostGain2();
void AdjustParm();

/* USER CODE END PFP */

/**
  * @brief  The application entry point.
  * @retval int
  */
int main(void)
{

  /* USER CODE BEGIN 1 */
	 HAL_GPIO_WritePin(GPIOD, YELLOW_LED_Pin, GPIO_PIN_SET);
	 Run_Gain = Run_Gain_Min;
	 Run_Gain_Scale = Run_Gain_Max - Run_Gain_Min;
	 Run_Gain_Conv_Factor = Run_Gain_Scale/ADC12_RANGE;

	 Run_Vol = Run_Vol_Min;
	 Run_Vol_Scale = Run_Vol_Max - Run_Vol_Min;
	 Run_Vol_Conv_Factor = Run_Vol_Scale/ADC12_RANGE;

	 Run_High = Run_High_Min;
	 Run_High_Scale = Run_High_Max - Run_High_Min;
	 Run_High_Conv_Factor = Run_High_Scale/ADC12_RANGE;

	 Run_Low = Run_LowCut_Min;
	 Run_LowCut_Max = Run_LowCut_Scale - Run_LowCut_Min;
	 Run_LowCut_Conv_Factor = Run_LowCut_Max/ADC12_RANGE;

	 //Initialize audio processing components:

	Init_FIR_Filter(&AntiAliasing_LowPass, ANTI_ALIAS10_SIZE, &AntiAlias_Coefs[0], &AntiAlias_LowPass_Buff[0], FIR_ON, 1);

	Init_QIIR_Filter(&Pregain_IIR0, HIGHPASS, 623.0f, 0.6f , 1.0f, ACTUAL_FS, QIIR_ON, 2, CTRL_OFF);
	Update_QIIR_Filter(&Pregain_IIR0);

	Init_QIIR_Filter(&Pregain_IIR1, BELL, 150.0f, 0.74f , 1.51f, ACTUAL_FS, QIIR_ON, 3, CTRL_OFF);
	Update_QIIR_Filter(&Pregain_IIR1);

	Init_QIIR_Filter(&Pregain_IIR2, BELL, 470.0f, 0.9f , 1.1f, ACTUAL_FS, QIIR_OFF, 4, CTRL_OFF);
	Update_QIIR_Filter(&Pregain_IIR2);

	Init_QIIR_Filter(&Pregain_IIR3, BELL, 2700.0f, 0.96f , 1.20f, ACTUAL_FS, QIIR_OFF, 5, CTRL_OFF);
	Update_QIIR_Filter(&Pregain_IIR3);

	Init_QIIR_Filter(&Pregain_IIR4, BELL, 1500.0f, 0.51f , 2.31f, ACTUAL_FS, QIIR_ON, 6, CTRL_OFF);
	Update_QIIR_Filter(&Pregain_IIR4);

	Init_QIIR_Filter(&Pregain_IIR5, BELL, 680.0f, 0.94f , 1.4f, ACTUAL_FS, QIIR_ON, 7, CTRL_OFF);
	Update_QIIR_Filter(&Pregain_IIR5);

	Init_QIIR_Filter(&Pregain_IIR6, LOWPASS, 5000.0f, 0.8f , 1.0f, ACTUAL_FS, QIIR_OFF, 8, CTRL_OFF);
	Update_QIIR_Filter(&Pregain_IIR6);


	Init_Drive(&GainStage1, 28.0f, 0.3f, 0.1f, 0.6f, 8.0f, 6.0f, DRIVE_ON, 9, CTRL_OFF);


	Init_QIIR_Filter(&MidGain_IIR0, LO_SHELF , 2000.0f, 0.8f, 0.9f, ACTUAL_FS, QIIR_OFF, 10, CTRL_OFF);
	Update_QIIR_Filter(&MidGain_IIR0);

	Init_QIIR_Filter(&MidGain_IIR1, LOWPASS , 8000.0f, 0.6f, 1.0f, ACTUAL_FS, QIIR_OFF, 11, CTRL_OFF);
	Update_QIIR_Filter(&MidGain_IIR1);

	Init_QIIR_Filter(&MidGain_IIR2, BELL , 720.0f, 0.8f, 0.9f, ACTUAL_FS, QIIR_OFF, 12, CTRL_OFF);
	Update_QIIR_Filter(&MidGain_IIR2);

	Init_QIIR_Filter(&MidGain_IIR3, BELL , 1800.0f, 0.5f, 1.3f, ACTUAL_FS, QIIR_OFF, 13, CTRL_OFF);
	Update_QIIR_Filter(&MidGain_IIR3);


	Init_Drive(&GainStage2, 18.0f, 0.05f, 0.6f, 0.8f, 20.0f, 10.0f, DRIVE_ON, 14, CTRL_OFF);


	Init_QIIR_Filter(&PostGain_IIR0, BELL, 90.0f, 0.96f , 1.652f, ACTUAL_FS, QIIR_ON, 15, CTRL_OFF);
	Update_QIIR_Filter(&PostGain_IIR0);

	Init_QIIR_Filter(&PostGain_IIR1, BELL, 2300.0f, 0.71f , 0.673f, ACTUAL_FS, QIIR_ON, 16, CTRL_OFF);
	Update_QIIR_Filter(&PostGain_IIR1);

	Init_QIIR_Filter(&PostGain_IIR2, LOWPASS, 12000.0f, 0.66f , 1.0f, ACTUAL_FS, QIIR_ON, 17, CTRL_OFF);
	Update_QIIR_Filter(&PostGain_IIR2);

	Init_QIIR_Filter(&PostGain_IIR3, BELL, 350.0f, 0.94f , 0.86f, ACTUAL_FS, QIIR_OFF, 17, CTRL_OFF);
	Update_QIIR_Filter(&PostGain_IIR3);

	Init_QIIR_Filter(&PostGain_IIR4, BELL, 4000.0f, 0.96f , 1.4f, ACTUAL_FS, QIIR_ON, 17, CTRL_OFF);
	Update_QIIR_Filter(&PostGain_IIR4);

	Init_QIIR_Filter(&PostGain_HP, HIGHPASS, 80.0f, 0.7f , 1.0f, ACTUAL_FS, QIIR_ON, 8, CTRL_OFF);
	Update_QIIR_Filter(&PostGain_HP);

	Init_FIR_Filter(&Cabinet_IR, IR_LEN, &Messa0_IR_Coefs[0], &Cabinet_IR_Buff[0], FIR_ON, 18);

  /* USER CODE END 1 */

  /* MPU Configuration--------------------------------------------------------*/
  MPU_Config();

  /* Enable the CPU Cache */

  /* Enable I-Cache---------------------------------------------------------*/
  SCB_EnableICache();

  /* Enable D-Cache---------------------------------------------------------*/
  SCB_EnableDCache();

  /* MCU Configuration--------------------------------------------------------*/

  /* Reset of all peripherals, Initializes the Flash interface and the Systick. */
  HAL_Init();

  /* Configure the system clock */
  SystemClock_Config();

  /* Configure the peripherals common clocks */
  PeriphCommonClock_Config();

  /* Initialize all configured peripherals */
  MX_GPIO_Init();
  MX_DMA_Init();
  MX_I2C1_Init();
  MX_I2S1_Init();
  MX_ADC1_Init();
  MX_I2C2_Init();
  MX_TIM8_Init();
  /* USER CODE BEGIN 2 */

  HAL_ADCEx_Calibration_Start(&hadc1, ADC_CALIB_OFFSET, ADC_SINGLE_ENDED);

  HAL_ADC_Start_DMA(&hadc1, (uint32_t *) POT_DATA, NUM_OF_POT);

  HAL_TIM_Base_Start(&htim8);
  //HAL_TIM_Base_Start_IT(&htim17);



  AIC320_codec.I2C_Handler = &hi2c2;
  AIC320_Init(&AIC320_codec);
  HAL_Delay(1000);
  I2S_Startup_Sts = HAL_I2SEx_TransmitReceive_DMA(&hi2s1,(uint16_t*)Audio_DAC_Buff, (uint16_t*)Audio_ADC_Buff,
		                        AUDIO_BUFF_SIZE16/2);

  HAL_GPIO_WritePin(GPIOD, YELLOW_LED_Pin, GPIO_PIN_RESET);

  /* USER CODE END 2 */

  /* Infinite loop */
  /* USER CODE BEGIN WHILE */
  while (1)
  {
    /* USER CODE END WHILE */

    /* USER CODE BEGIN 3 */
	if (Stream_Status == CAN_PROCEED_STREAM){
		Process_Audio();
	}

  }
  /* USER CODE END 3 */
}

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
/* USER CODE BEGIN 4 */
void HAL_ADC_ConvCpltCallback(ADC_HandleTypeDef *hadc){
	Run_Vol		= Run_Vol_Min + (POT_DATA[0] * Run_Vol_Conv_Factor);
	if (Run_Vol < 0.0003f){
		Run_Vol = 0;
	}

	Run_Gain 	= Run_Gain_Min + (POT_DATA[1] * Run_Gain_Conv_Factor);
	Run_Low		= Run_LowCut_Min + Run_LowCut_Max - (POT_DATA[2] * Run_LowCut_Conv_Factor);
	Run_High	= Run_High_Min + (POT_DATA[3] * Run_High_Conv_Factor);

}


void HAL_I2SEx_TxRxCpltCallback(I2S_HandleTypeDef *hi2s){
	Audio_Inp_Ptr = &Audio_ADC_Buff[AUDIO_BUFF_SIZE16/2];
	Audio_Out_Ptr = &Audio_DAC_Buff[AUDIO_BUFF_SIZE16/2];
	Stream_Status = CAN_PROCEED_STREAM;
}

void HAL_I2SEx_TxRxHalfCpltCallback(I2S_HandleTypeDef *hi2s){
	Audio_Inp_Ptr = &Audio_ADC_Buff[0];
	Audio_Out_Ptr = &Audio_DAC_Buff[0];
	Stream_Status = CAN_PROCEED_STREAM;
}

void Process_Audio(){
	static float Left_Stream_Inp = 0.0f;
	static int32_t Left_Stream_Inp_Int = 0;

	static float Left_Stream_Out = 0.0f;
	static int32_t Left_Stream_Out_Int = 0;

	//static float Right_Stream_Inp;
	//static float Right_Stream_Out;

	Global_Lvl_Out = Run_Vol;
	GainStage1.Inp_Lvl = Run_Gain;

	PostGain_IIR2.F0 = Run_High;
	Update_QIIR_Filter(&PostGain_IIR2);

	PostGain_HP.F0 = Run_Low;
	Update_QIIR_Filter(&PostGain_HP);

	for (int n = 0; n < (AUDIO_BUFF_SIZE16/2) - 3 ; n += 4){

		inp_i16_0 = ((int32_t)Audio_Inp_Ptr[n]<<8) & 0x0000FF00 ;
		inp_i16_1 = ((int32_t)Audio_Inp_Ptr[n]<<8) & 0x00FF0000;
		inp_i16_2 = ((int32_t)Audio_Inp_Ptr[n+1]<<24) & 0xFF000000;


		i1_int_combined  =  (  ((int32_t)inp_i16_0)  |  ((int32_t)inp_i16_1)   |  ((int32_t)inp_i16_2)  );
		Left_Stream_Inp_Int = i1_int_combined;


		Left_Stream_Inp =  (float) (INT32_TO_FLOAT * Left_Stream_Inp_Int);


		if (fx_switch == FX_ACTIVE){
			//Do some magic here :
			Left_Stream_Out = Left_Stream_Inp;
			Left_Stream_Out = Process_FIR_Filter(&AntiAliasing_LowPass, Left_Stream_Inp);
			Left_Stream_Inp = Left_Stream_Out;

			//Process IIR0
			Left_Stream_Out = Process_QIIR_Filter(&Pregain_IIR0, Left_Stream_Inp);
			Left_Stream_Inp = Left_Stream_Out;

			//Process IIR1
			Left_Stream_Out = Process_QIIR_Filter(&Pregain_IIR1, Left_Stream_Inp);
			Left_Stream_Inp = Left_Stream_Out;

			//Process IIR2
			Left_Stream_Out = Process_QIIR_Filter(&Pregain_IIR2, Left_Stream_Inp);
			Left_Stream_Inp = Left_Stream_Out;

			//Process IIR3
			Left_Stream_Out = Process_QIIR_Filter(&Pregain_IIR3, Left_Stream_Inp);
			Left_Stream_Inp = Left_Stream_Out;

			//Process IIR4
			Left_Stream_Out = Process_QIIR_Filter(&Pregain_IIR4, Left_Stream_Inp);
			Left_Stream_Inp = Left_Stream_Out;

			//Process IIR5
			Left_Stream_Out = Process_QIIR_Filter(&Pregain_IIR5, Left_Stream_Inp);
			Left_Stream_Inp = Left_Stream_Out;

			//Process IIR6
			Left_Stream_Out = Process_QIIR_Filter(&Pregain_IIR6, Left_Stream_Inp);
			Left_Stream_Inp = Left_Stream_Out;

			//Gain stage 1
			Update_Drive(&GainStage1);
			Left_Stream_Out = Process_Drive(&GainStage1, Left_Stream_Inp);
			Left_Stream_Inp = Left_Stream_Out;

			Left_Stream_Out = Process_QIIR_Filter(&MidGain_IIR0, Left_Stream_Inp);
			Left_Stream_Inp = Left_Stream_Out;

			//Process Midgain IIR1
			Left_Stream_Out = Process_QIIR_Filter(&MidGain_IIR1, Left_Stream_Inp);
			Left_Stream_Inp = Left_Stream_Out;

			//Process Midgain IIR2
			Left_Stream_Out = Process_QIIR_Filter(&MidGain_IIR2, Left_Stream_Inp);
			Left_Stream_Inp = Left_Stream_Out;

			//Process Midgain IIR3
			Left_Stream_Out = Process_QIIR_Filter(&MidGain_IIR3, Left_Stream_Inp);
			Left_Stream_Inp = Left_Stream_Out;

			if (Gain_Mode != CRUNCH_MODE){
				//Gain stage 2
				Update_Drive(&GainStage2);
				Left_Stream_Out = Process_Drive(&GainStage2, Left_Stream_Inp);
				Left_Stream_Inp = Left_Stream_Out;
			}

			Left_Stream_Out = Process_QIIR_Filter(&PostGain_IIR0, Left_Stream_Inp);
			Left_Stream_Inp = Left_Stream_Out;

			Left_Stream_Out = Process_QIIR_Filter(&PostGain_IIR1, Left_Stream_Inp);
			Left_Stream_Inp = Left_Stream_Out;

			Left_Stream_Out = Process_QIIR_Filter(&PostGain_IIR2, Left_Stream_Inp);
			Left_Stream_Inp = Left_Stream_Out;

			Left_Stream_Out = Process_QIIR_Filter(&PostGain_IIR3, Left_Stream_Inp);
			Left_Stream_Inp = Left_Stream_Out;

			Left_Stream_Out = Process_QIIR_Filter(&PostGain_IIR4, Left_Stream_Inp);
			Left_Stream_Inp = Left_Stream_Out;

			Left_Stream_Out = Process_QIIR_Filter(&PostGain_HP, Left_Stream_Inp);
			Left_Stream_Inp = Left_Stream_Out;

			Left_Stream_Out = Process_FIR_Filter(&Cabinet_IR, Left_Stream_Inp);
		}
		else{
			Left_Stream_Out = Left_Stream_Inp;
		};

		Left_Stream_Out = Left_Stream_Out * Global_Lvl_Out;

		if (Left_Stream_Out > 0.085){
			HAL_GPIO_WritePin(GPIOD, YELLOW_LED_Pin, GPIO_PIN_SET);
		}
		else{
			HAL_GPIO_WritePin(GPIOD, YELLOW_LED_Pin, GPIO_PIN_RESET);
		}


		Left_Stream_Out_Int =  ( Left_Stream_Out * FLOAT_TO_INT32);

		out_i16_2 = (Left_Stream_Out_Int>>24) 	& 0x000000FF;
		out_i16_1= (Left_Stream_Out_Int>>8)	& 0x000000FF;
		out_i16_0= (Left_Stream_Out_Int>>8)	& 0x0000FF00;


		Audio_Out_Ptr[n] = out_i16_1 | out_i16_0;
		Audio_Out_Ptr[n+1] = out_i16_2;

		Audio_Out_Ptr[n+2] = Audio_Inp_Ptr[n+2];
		Audio_Out_Ptr[n+3] = Audio_Inp_Ptr[n+3];

	}
	Stream_Status = DONT_PROCEED_STREAM;
}

void HAL_GPIO_EXTI_Callback(uint16_t GPIO_Pin){
	switch (GPIO_Pin){
	case BTN_1_Pin:
		if (fx_switch == FX_ACTIVE){
			fx_switch = FX_BYPASS;
		}
		else{
			fx_switch = FX_ACTIVE;
		}
		break;


	case BTN_2_Pin:

		if (Gain_Mode == LEAD_MODE){
			Gain_Mode = CRUNCH_MODE;
		}
		else
		{
			Gain_Mode = LEAD_MODE;
		}
		break;

	case BTN_3_Pin:
	default:
		break;
	}
}

void Check_State_Change_Request(){
	if ((Change_Request_Status == DONE_APPLY) || (Change_Request_Status == DONE_CANCEL)){
		Current_Run_State = ON_RUN;
		Button_Assign_To_Process_ID = 0;
		Change_Request_Status = ON_RUN;
	}
}





/* USER CODE END 4 */

 /* MPU Configuration */

void MPU_Config(void)
{
  MPU_Region_InitTypeDef MPU_InitStruct = {0};

  /* Disables the MPU */
  HAL_MPU_Disable();

  /** Initializes and configures the Region and the memory to be protected
  */
  MPU_InitStruct.Enable = MPU_REGION_ENABLE;
  MPU_InitStruct.Number = MPU_REGION_NUMBER0;
  MPU_InitStruct.BaseAddress = 0x38000000;
  MPU_InitStruct.Size = MPU_REGION_SIZE_64KB;
  MPU_InitStruct.SubRegionDisable = 0x00;
  MPU_InitStruct.TypeExtField = MPU_TEX_LEVEL0;
  MPU_InitStruct.AccessPermission = MPU_REGION_FULL_ACCESS;
  MPU_InitStruct.DisableExec = MPU_INSTRUCTION_ACCESS_DISABLE;
  MPU_InitStruct.IsShareable = MPU_ACCESS_NOT_SHAREABLE;
  MPU_InitStruct.IsCacheable = MPU_ACCESS_NOT_CACHEABLE;
  MPU_InitStruct.IsBufferable = MPU_ACCESS_NOT_BUFFERABLE;

  HAL_MPU_ConfigRegion(&MPU_InitStruct);
  /* Enables the MPU */
  HAL_MPU_Enable(MPU_PRIVILEGED_DEFAULT);

}

/**
  * @brief  This function is executed in case of error occurrence.
  * @retval None
  */
void Error_Handler(void)
{
  /* USER CODE BEGIN Error_Handler_Debug */
  /* User can add his own implementation to report the HAL error return state */
  __disable_irq();
  while (1)
  {
  }
  /* USER CODE END Error_Handler_Debug */
}

#ifdef  USE_FULL_ASSERT
/**
  * @brief  Reports the name of the source file and the source line number
  *         where the assert_param error has occurred.
  * @param  file: pointer to the source file name
  * @param  line: assert_param error line source number
  * @retval None
  */
void assert_failed(uint8_t *file, uint32_t line)
{
  /* USER CODE BEGIN 6 */
  /* User can add his own implementation to report the file name and line number,
     ex: printf("Wrong parameters value: file %s on line %d\r\n", file, line) */
  /* USER CODE END 6 */
}
#endif /* USE_FULL_ASSERT */
