garin29/Guitar-Amp-Sim/Core/Inc/main.h

#define BTN_1_Pin GPIO_PIN_4
#define BTN_1_GPIO_Port GPIOE
#define BTN_1_EXTI_IRQn EXTI4_IRQn
#define BTN_2_Pin GPIO_PIN_5
#define BTN_2_GPIO_Port GPIOE
#define BTN_2_EXTI_IRQn EXTI9_5_IRQn
#define BTN_3_Pin GPIO_PIN_0
#define BTN_3_GPIO_Port GPIOF
#define BTN_3_EXTI_IRQn EXTI0_IRQn
#define SPI2_CS_Pin GPIO_PIN_12
#define SPI2_CS_GPIO_Port GPIOB
#define CODEC_NRST_Pin GPIO_PIN_11
#define CODEC_NRST_GPIO_Port GPIOD
#define OUT_SIGN_Pin GPIO_PIN_6
#define OUT_SIGN_GPIO_Port GPIOG
#define YELLOW_LED_Pin GPIO_PIN_2
#define YELLOW_LED_GPIO_Port GPIOD
#define RED_LED_Pin GPIO_PIN_4
#define RED_LED_GPIO_Port GPIOD
