garin29/Guitar-Amp-Sim/Hardware Looks/PVB view 3.jpg

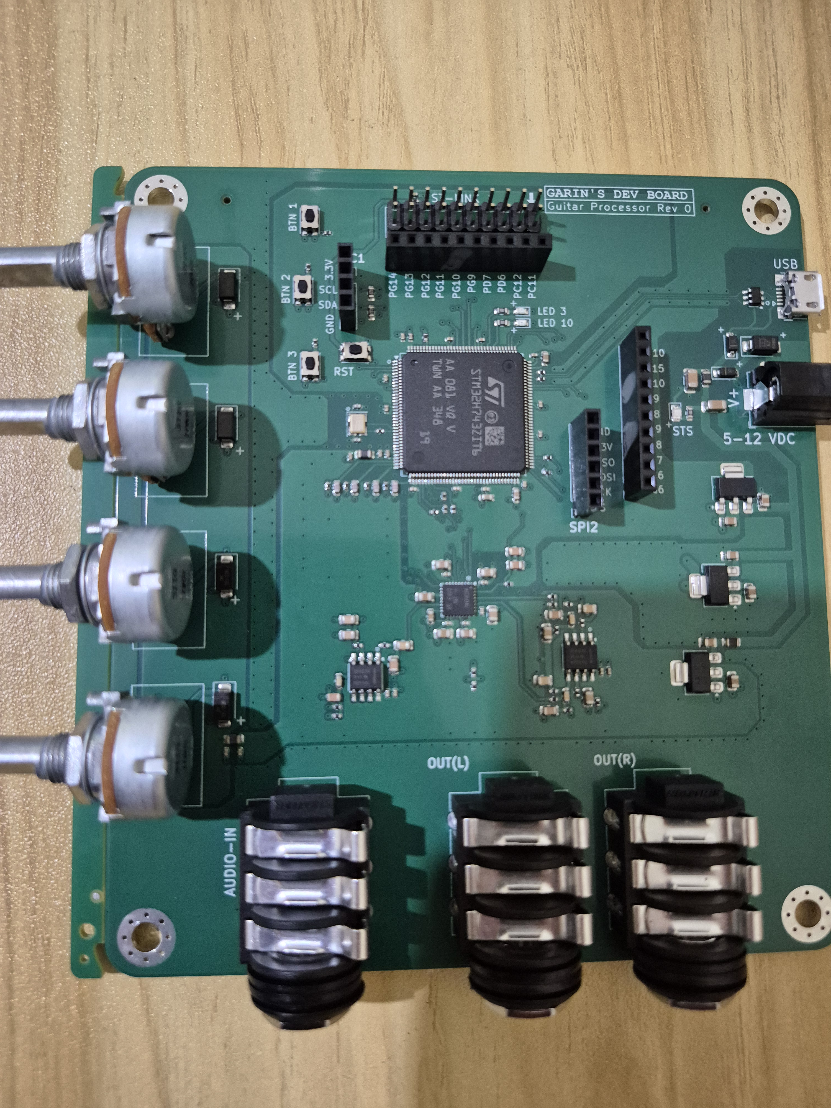
Hardware Looks/PVB view 3.jpg
