garin29/Guitar-Amp-Sim/Hardware Looks/PCB view 1.jpg

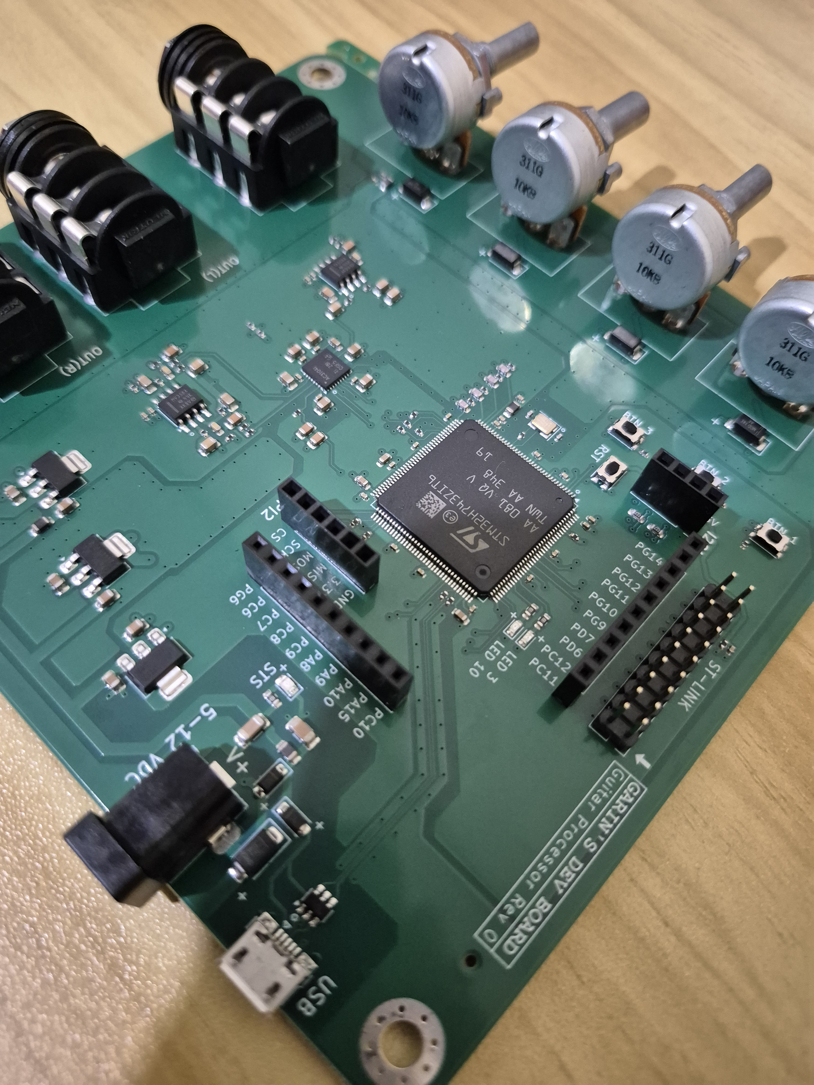
Hardware Looks/PCB view 1.jpg
