garin29/Guitar-Amp-Sim/Hardware Looks/PVB view 2.jpg

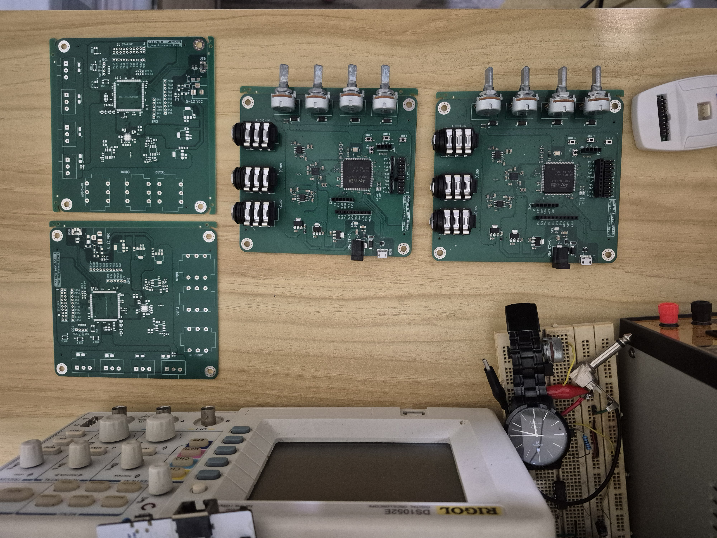
Hardware Looks/PVB view 2.jpg
